Cioshima/Senior-Design-Project/CDR Presentation.pdf

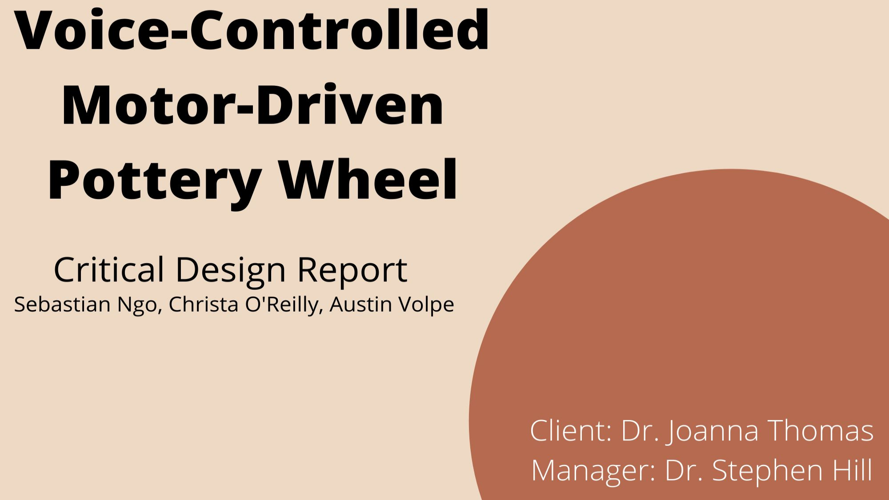
[picture p1: page 1]

## Introduction

- Client: Dr. Joanna Thomas
- Problem: Lack of accessibility of standard foot-pedal operated motor-driven pottery wheel

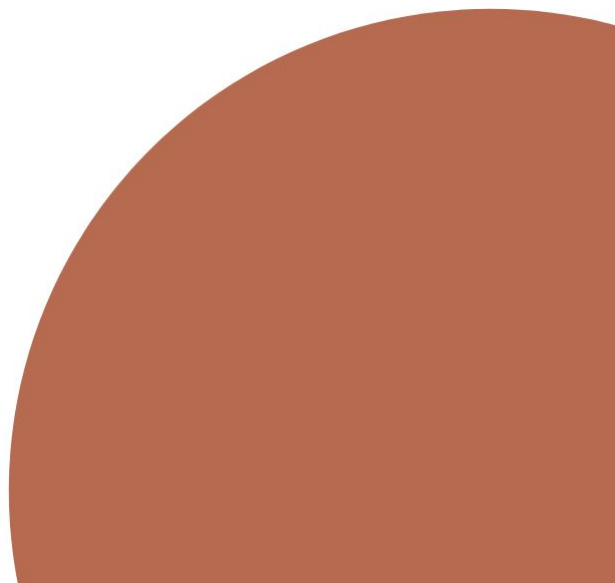
[picture p2: figure]

- Task: Modify pottery wheel to be voice-controlled

## PDR Summary

- Goal: Remove potentiometer and wire motor to microprocessor

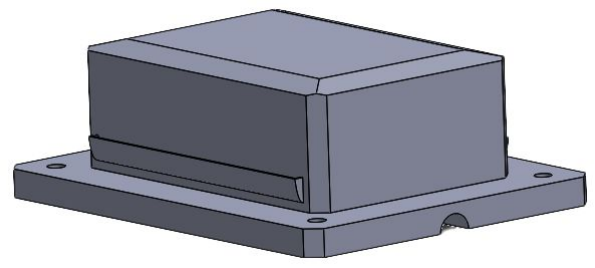
[picture p3: figure]

- Given several specifications by client
- Analyzed multiple options:
- Microprocessor - Arduino Nano 33 BLE Sense
- Housing - 3D Printed PLA
- Initial Expected Cost: $214 per unit

## Specifications

- Voice - controlled
- 10 distinct speeds
- Respond to a set of commands
- Programmable name
- Respond to a voice of 50dB within 3 feet
- LED indicator light

## Criteria

- Specifications given to us; however we added some more
- Safe to use
- Time of construction
- Cost to build
- Reliability
- Coding ease

## Roles and Responsibility

- Sebastian Ngo
- Computer Engineer
- Coding and software
- Christa O’Reilly
- Biomedical Engineer
- Hardware and team management
- Austin Volpe
- Mechanical Engineer
- Physical modifications and housing design

## Design Revision

- Used a Google Dataset that provided an abundant amount of voice samples

from random people (1500 for each voice command)

- Curate/Mix samples of background samples to simulate users saying a

command in a noisy environment

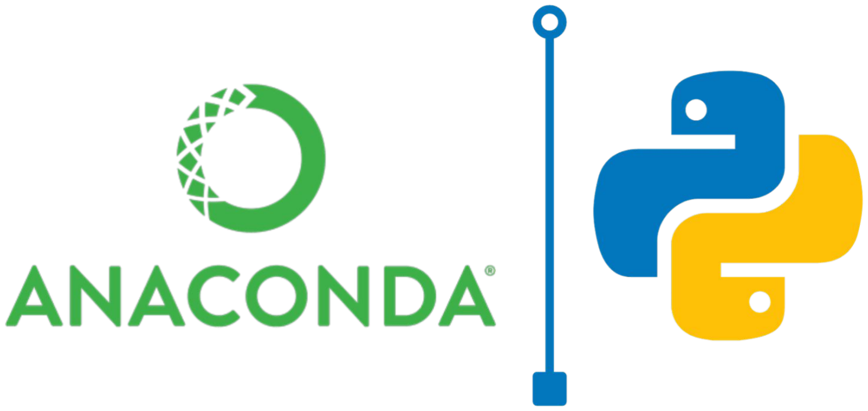
[picture p4: figure]

## Design Revision

- Original Design: Implementing a trigger word to allow the microcontroller to

listen for commands and have the pottery wheel change up to 10 different

speeds.

- Revision: Microcontroller does not have a trigger word, and the wheel can

only go up to 4 speeds.

## Design Revision

- Imported the neural network model into the arduino IDE and coded the

interaction between the microcontroller and pottery wheel

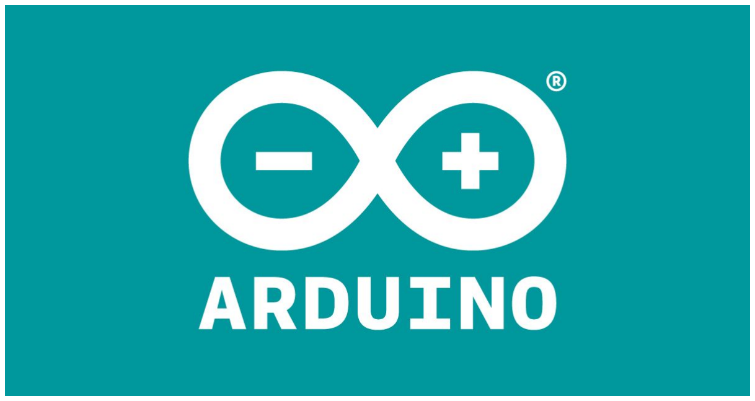
[picture p5: figure]

## Design Revision

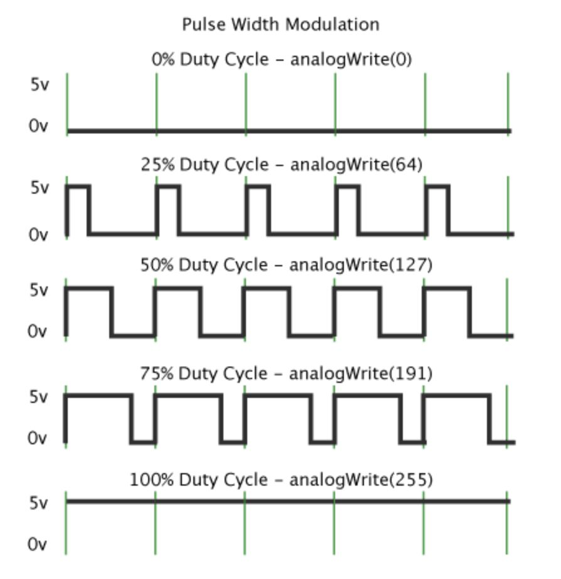
[picture p6: figure]

- Used analogWrite() to specify rotation

speed

- PWM only works on pins 3,5,6,9,10,

therefore we used pin 6 as our output

## Design Revision

- Pottery Wheel was staggering in between

analogWrite(0-255)

- Solution: Increase the frequency of the pins

## Design Revision

- Removed analogWrite() and used a library

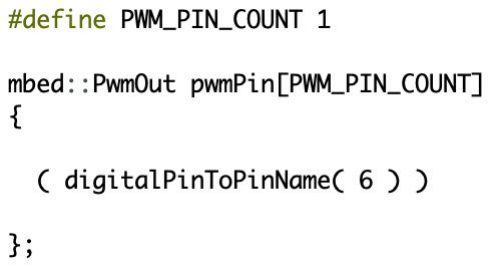
[picture p7: figure]

called mbed.os which allows us to control the

frequency of the designated pin

- Increased pin 6 from 500Hz to 25kHz.

## Design Revision

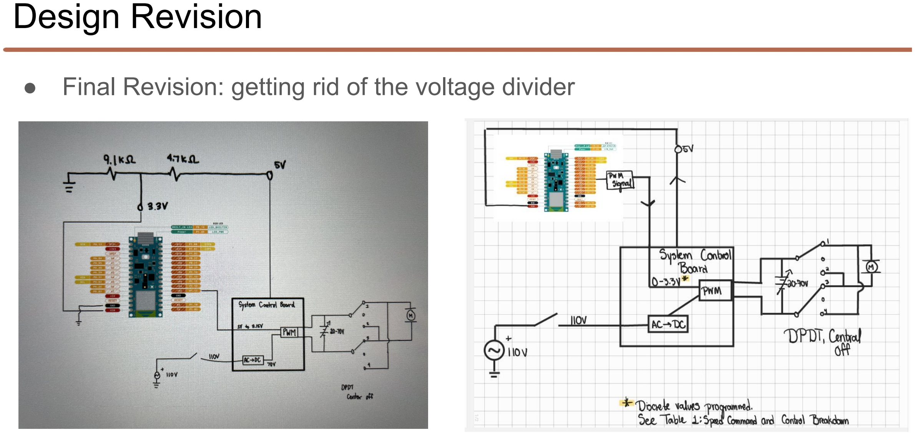
[picture p8: page 13]

- Final Revision: getting rid of the voltage divider

## Design Revision

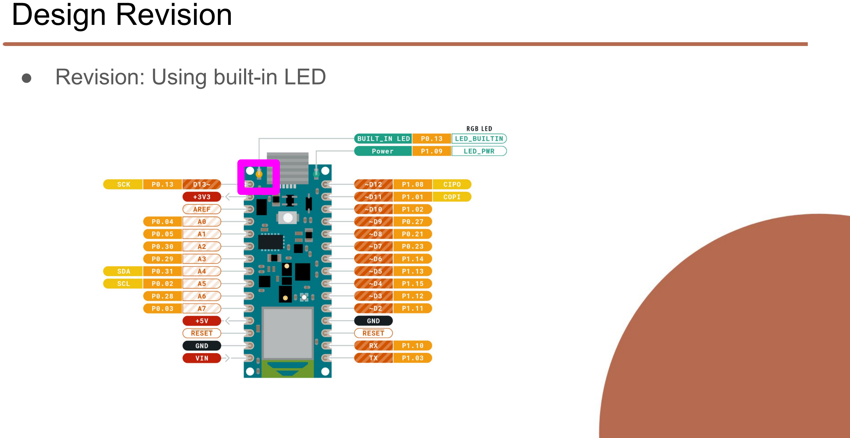
[picture p9: page 14]

- Revision: Using built-in LED

## Design Revision - Electrical Housing

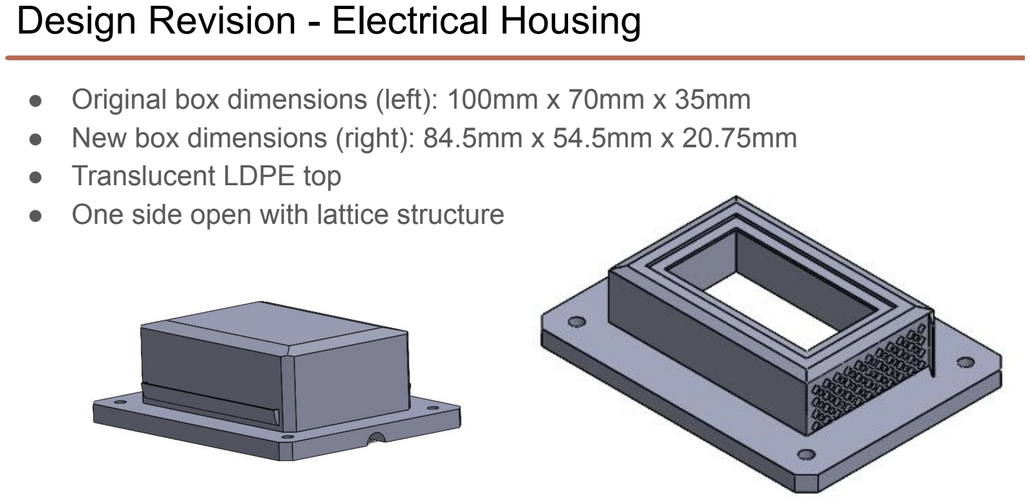
[picture p10: page 15]

- Original box dimensions (left): 100mm x 70mm x 35mm
- New box dimensions (right): 84.5mm x 54.5mm x 20.75mm
- Translucent LDPE top
- One side open with lattice structure

## Final Design

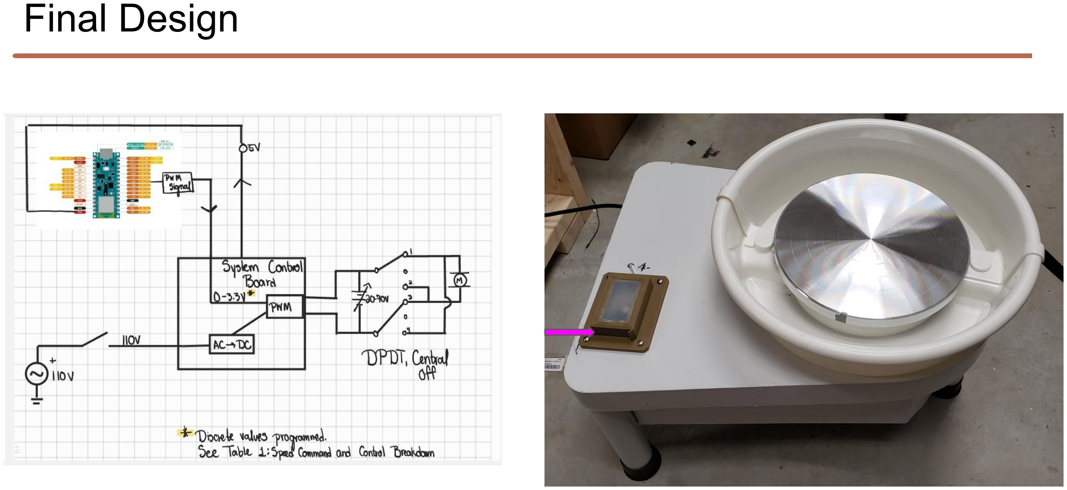
[picture p11: page 16]

## Final Design

https://drive.google.com/file/d/1vBZUzALuUZbJJ7moRylLQpB6ywibruYV/view?usp=sharing

https://drive.google.com/file/d/1kOR277iv4HxQKSw67mto6k9YN1AAgqDK/view?usp=sharing

## Test Results

- It Worked!
- Smooth transitions
- No stopping or stuttering during the spinning
- RPM=73.7(volts)-72.7
Speed Command | Duty Cycle Value | Voltage | Rotation per Minutes | LED Color
Zero | 0 | 0 Volts | 0 | Black/Off
One | 0.4 | 1.30 Volts | 23.11 | Red
Two | 0.6 | 1.96 Volts | 71.75 | Green
Three | 0.8 | 2.62 Volts | 120.4 | Blue
Four | 1.0 | 3.30 Volts | 170.5 | Yellow

## Test Results

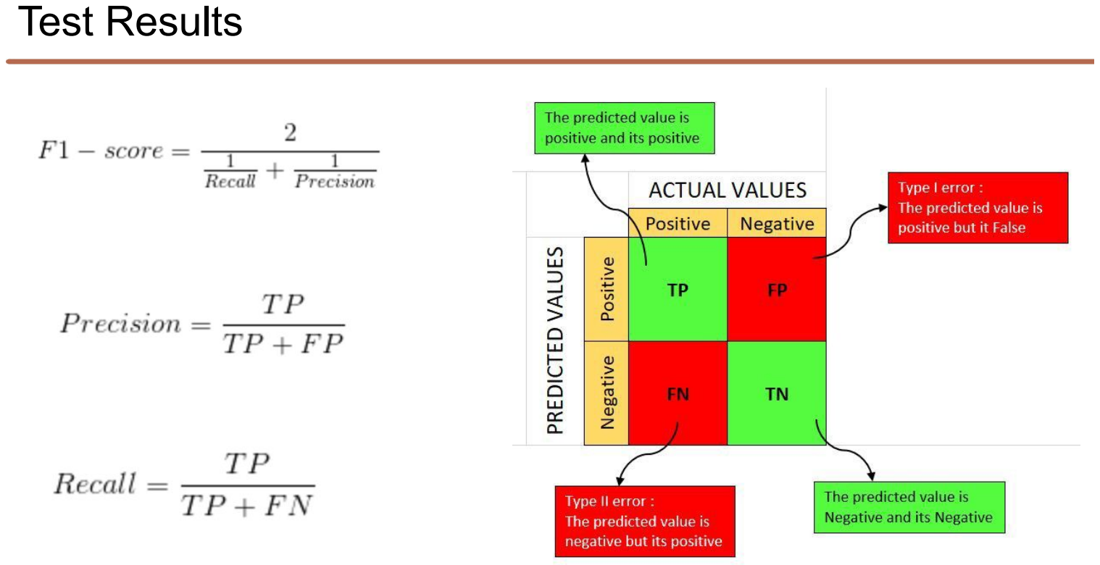
[picture p12: page 19]

## Test Results

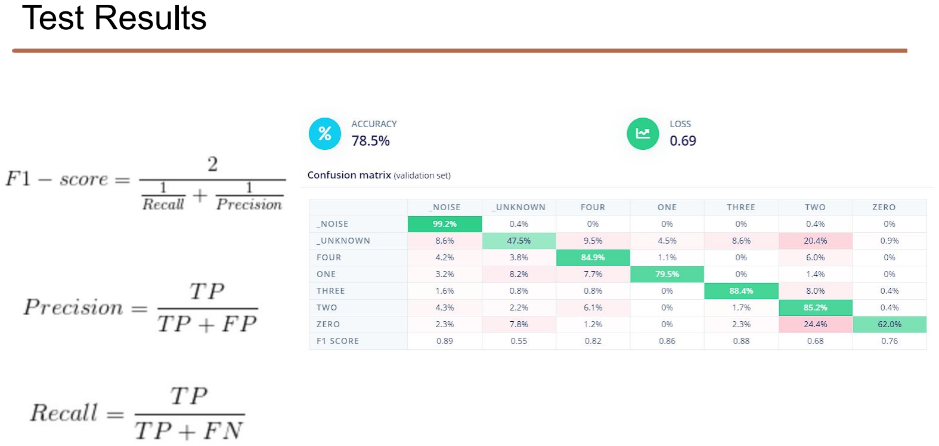
[picture p13: page 20]

## Test Results

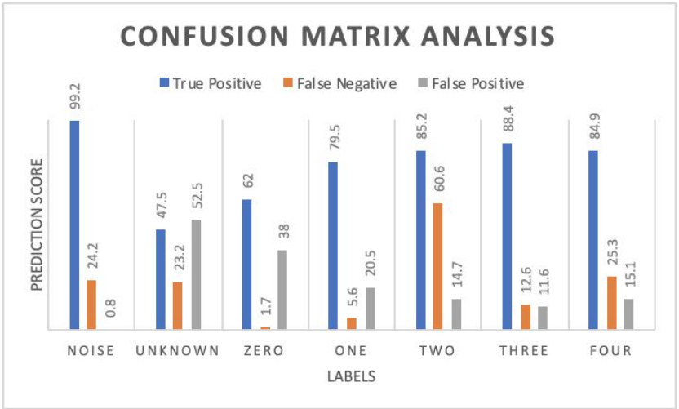
[picture p14: figure]

## Test Results

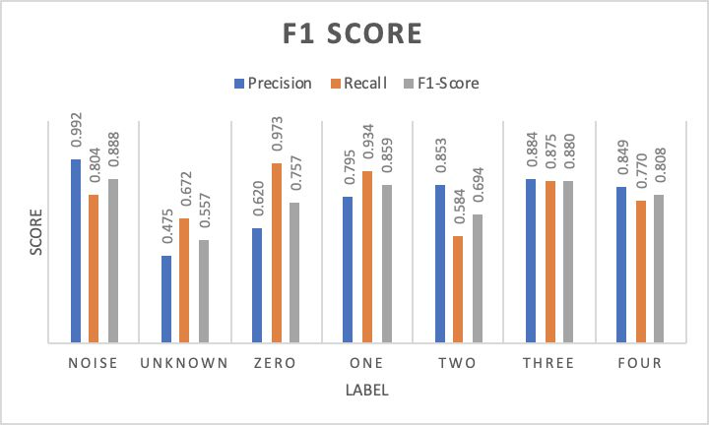
[picture p15: figure]

## Test Results

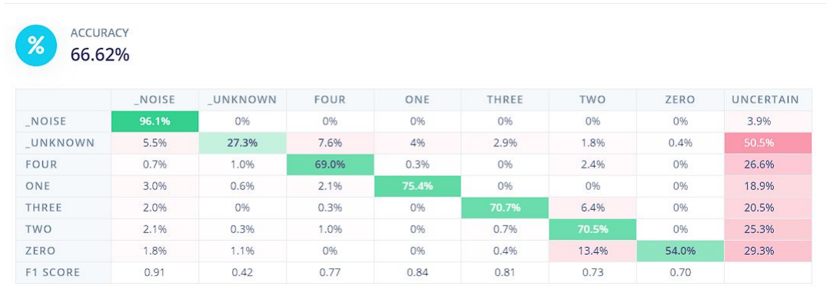
[picture p16: figure]

## Test Results

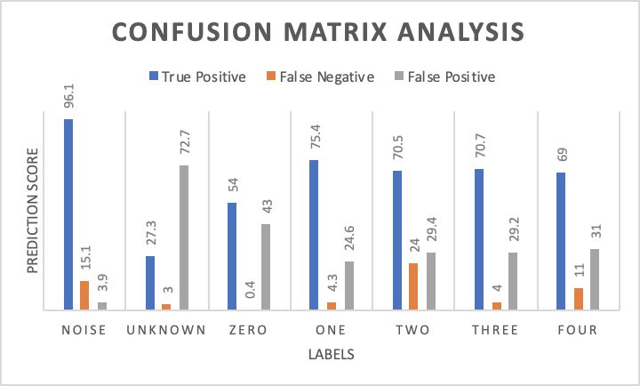
[picture p17: figure]

## Test Results

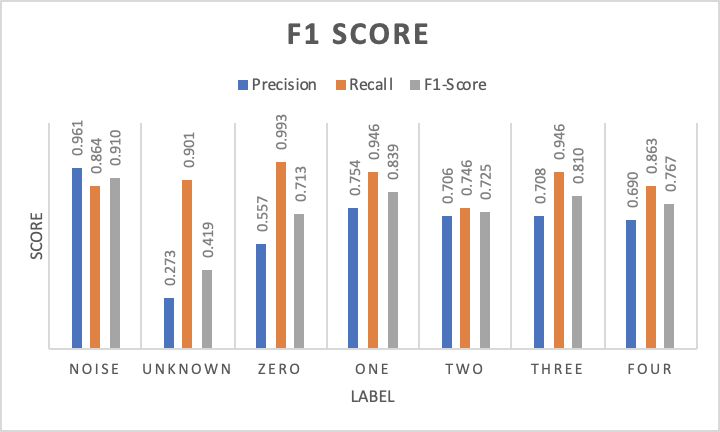
[picture p18: figure]

## Cost Breakdown

Item | Total Cost | Individual Cost
Arduino Nano 33 | $22.50 | N/A
Arduino Nano 33 (post inflation) | $38.85 | N/A
- Total Cost: 299 dollars. | 9.1K Ohm Resistor (15 pack) | | $9.77 | $0.65

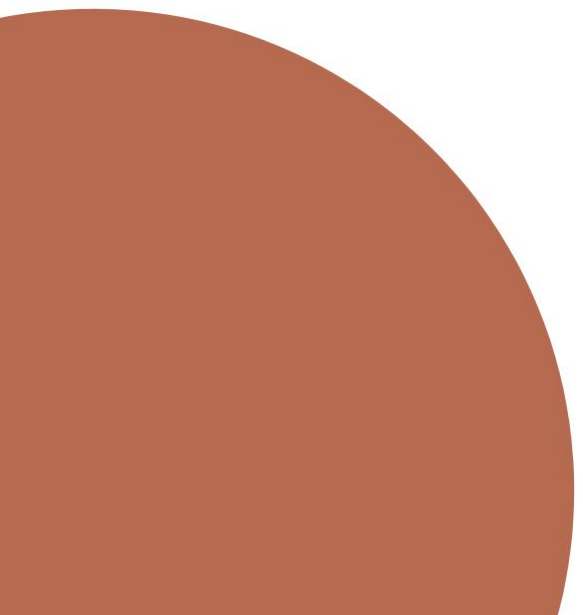
[picture p19: figure]

| 4.7K Ohm Resistors (10 pack) | | $5.76 | $0.58
| 10K Ohm Resistors (100 pack) | | $5.00 | $0.05
| OPA4196 | | $5.00 | N/A
| LCD Screen | | $12.00 | N/A
| External Microphone | | $9.00 | N/A
| Pottery Wheel | | $163.99 | N/A
| Bolts (need two packs) | | $3.02 | $1.51
| Washers | | $1.00 | N/A
| Nuts (need two packs) | | $1.88 | $0.94
| PLA | | $22.99 | N/A

## Cost Breakdown

- Project Cost: $231 dollars
Item | Total Cost | Individual Cost
Arduino Nano 33 | $38.50 | N/A
Pottery Wheel | $163.99 | N/A
Bolts (need two packs) | $3.02 | $1.51
Washers | $1.00 | N/A
Nuts (need two packs) | $1.88 | $0.94
PLA | $22.99 | N/A

## Recommendations

- Different pottery wheel
- More voltage and power

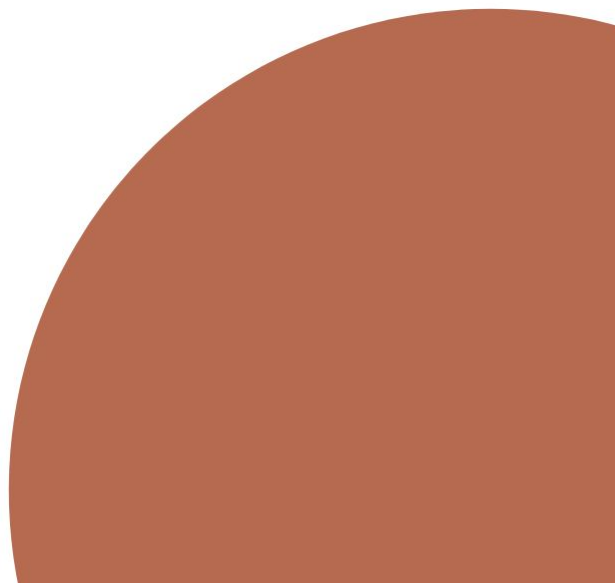
[picture p20: figure]

- Better Microcontroller
- More neural network training
- Increase budget

## Project Summary

- Modified a motor-driven pottery wheel to be voice-controlled
- Responds to “Zero,” “One,” “Two,” “Three,” “Four”
- Used an Arduino Nano and made housing from 3D printed PLA/LDPE
- Unit Cost: $231
- Final product works well, but we have a few recommendations before

proceeding

# Questions

Contact Information
Sebastian Ngo:SebastianSy.Vuchi.Ngo@live.mercer.edu
Christa O’Reilly: | christa.oreilly@live.mercer.edu
Austin Volpe: | austin.m.volpe@live.mercer.edu
